eraticus/Squid_old/squid version 14.brd

## EAGLE design squid version 14.brd (2014-09-12)

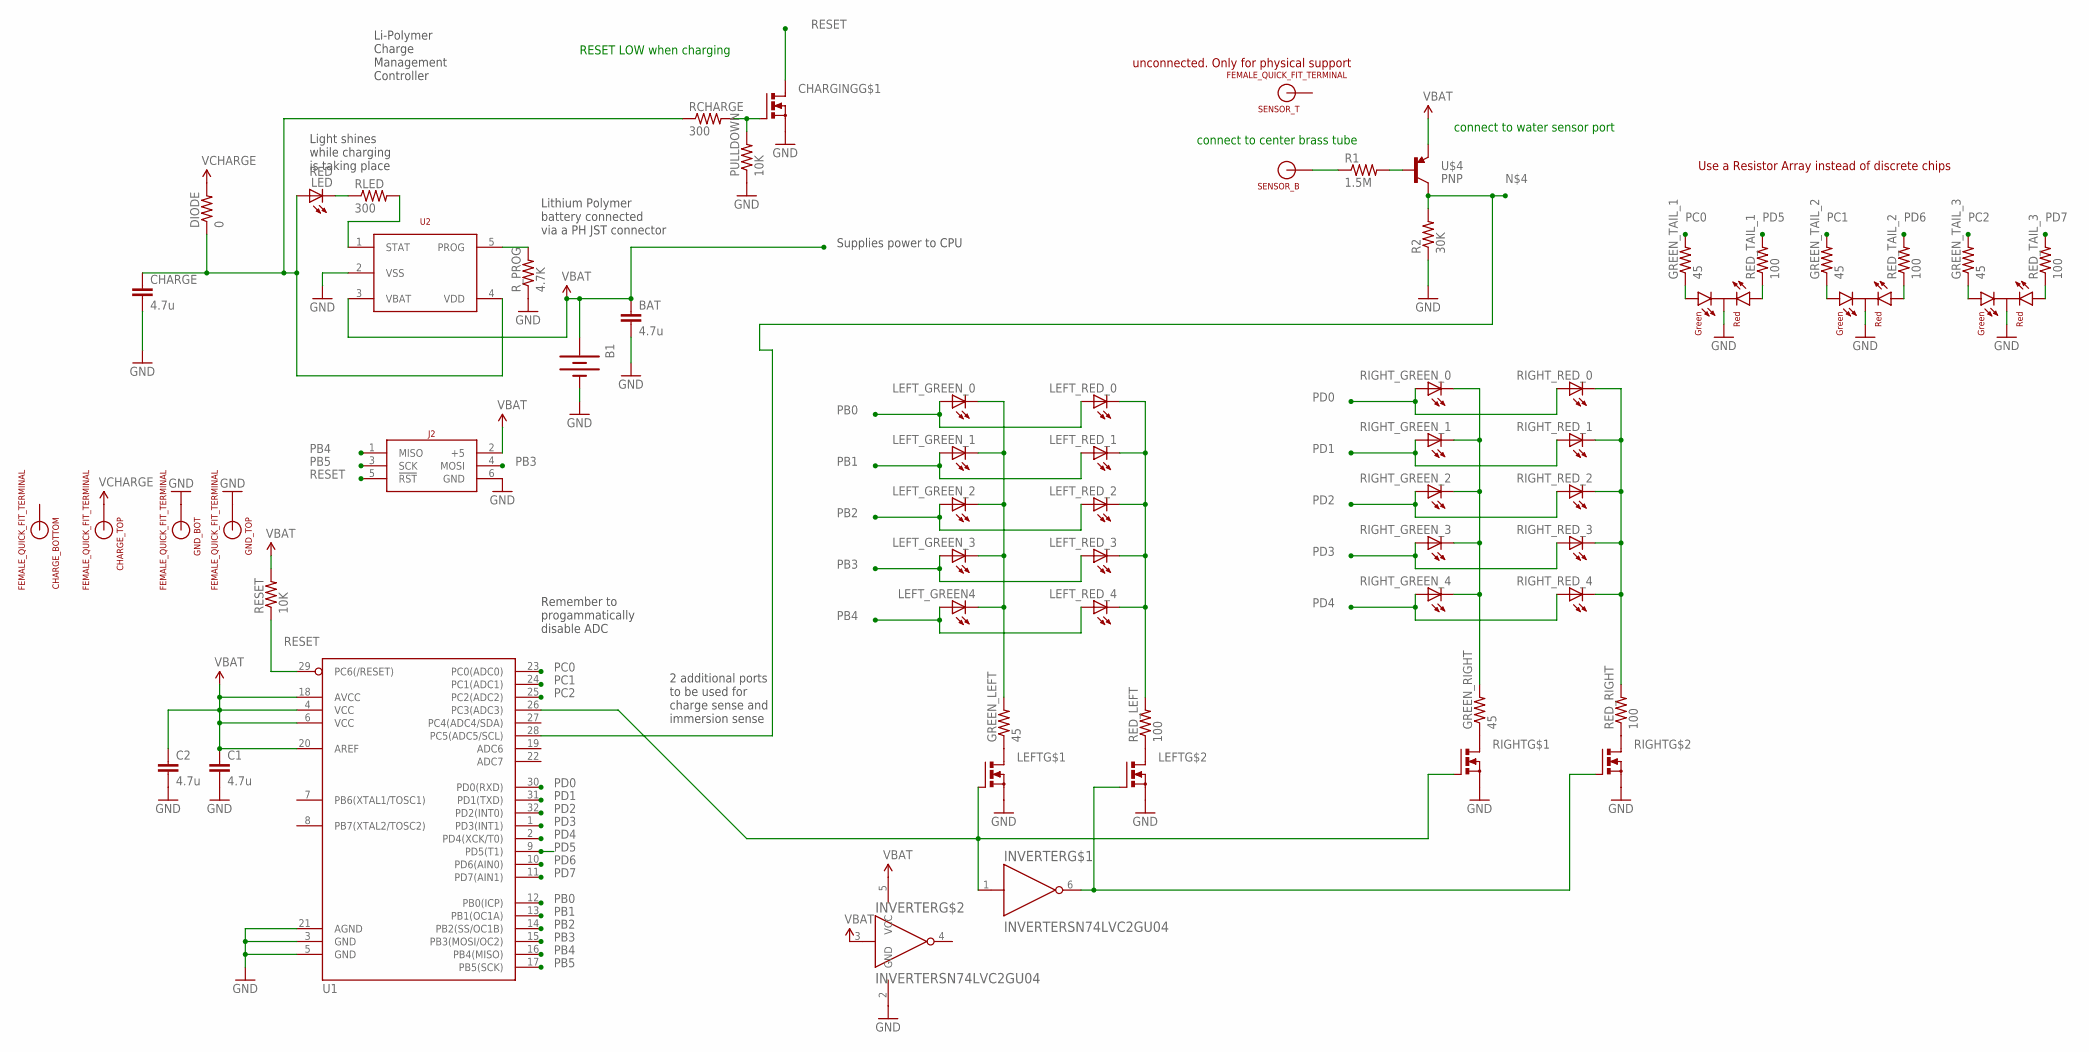
[picture p1: schematic squid version 14.sch]

Parts:
B1: COIN_CELL_BATTERYJST; JST_SM
BAT: 4.7u; 1206
C1, C2: 4.7u; 1206
CENTER: LED_RED_GREEN_CC; LED_KINGBRIGHT_BICOLOR_INDICATOR_LAMP
CHARGE: 4.7u; 1206
CHARGE_BOTTOM: FEMALE_QUICK_FIT_TERMINAL; HORIZONTAL_QUICK_CONNECT_3547
CHARGE_TOP: FEMALE_QUICK_FIT_TERMINAL; HORIZONTAL_QUICK_CONNECT_3547
CHARGING: MOSFET_N_DUAL; SOT-23-6
DIODE: 0; 0805
GND_BOT: FEMALE_QUICK_FIT_TERMINAL; HORIZONTAL_QUICK_CONNECT_3547
GND_TOP: FEMALE_QUICK_FIT_TERMINAL; HORIZONTAL_QUICK_CONNECT_3547
GREEN_LEFT: 45; 0805
GREEN_RIGHT: 45; 0805
GREEN_TAIL_1, GREEN_TAIL_2, GREEN_TAIL_3: 45; 0805
INVERTER: INVERTERSN74LVC2GU04; SOT-23-6
J2: ATMEL_PROGRAMMER_HEADERNL; TC2030-INC-NL
LED: RED; CHIP-LED0805
LEFT: MOSFET_N_DUAL; SOT-23-6
LEFT_GREEN4: LEDPLCC2; BIVAR_2-PLCC
LEFT_GREEN_0, LEFT_GREEN_1, LEFT_GREEN_2, LEFT_GREEN_3: LEDPLCC2; BIVAR_2-PLCC
LEFT_RED_0, LEFT_RED_1, LEFT_RED_2, LEFT_RED_3, LEFT_RED_4: LEDPLCC2; BIVAR_2-PLCC
PULLDOWN: 10K; 0805
R1: 1.5M; 0805
R2: 30K; 0805
RCHARGE: 300; 0805
RED_LEFT: 100; 0805
RED_RIGHT: 100; 0805
RED_TAIL_1, RED_TAIL_2, RED_TAIL_3: 100; 0805
RESET: 10K; 0805
RIGHT: MOSFET_N_DUAL; SOT-23-6
RIGHT_GREEN_0, RIGHT_GREEN_1, RIGHT_GREEN_2, RIGHT_GREEN_3, RIGHT_GREEN_4: LEDPLCC2; BIVAR_2-PLCC
RIGHT_RED_0, RIGHT_RED_1, RIGHT_RED_2, RIGHT_RED_3, RIGHT_RED_4: LEDPLCC2; BIVAR_2-PLCC
RLED: 300; 0805
R_PROG: 4.7K; 0805
SENSOR_B: FEMALE_QUICK_FIT_TERMINAL; HORIZONTAL_QUICK_CONNECT_3547
SENSOR_T: FEMALE_QUICK_FIT_TERMINAL; HORIZONTAL_QUICK_CONNECT_3547
U1: ATMEGA328_SMT; TQFP32-08
U2: MCP73832; SOT-23(OT)5_LEAD
U$4: PNP; SOT-23
U$7, U$13: LED_RED_GREEN_CC; LED_KINGBRIGHT_BICOLOR_INDICATOR_LAMP

Connections:
GND: B1.GND (-), BAT.2, C1.2, C2.2, CENTER.2 (C), CHARGE.2, CHARGING.4 (S), GND_BOT.1, GND_TOP.1, INVERTER.2 (GND), J2.6 (GND), LEFT.1 (S), LEFT.4 (S), PULLDOWN.1, R2.1, RIGHT.1 (S), RIGHT.4 (S), R_PROG.1, U1.3 (GND), U1.5 (GND), U1.21 (AGND), U2.2 (VSS), U$7.2 (C), U$13.2 (C)
GREEN_LEFT_CATHODE: GREEN_LEFT.2, LEFT_GREEN4.C, LEFT_GREEN_0.C, LEFT_GREEN_1.C, LEFT_GREEN_2.C, LEFT_GREEN_3.C
unnamed: R1.2, U$4.1 (B)
unnamed: INVERTER.6 (Y), LEFT.2 (G), RIGHT.2 (G)
unnamed: CHARGING.5 (G), PULLDOWN.2, RCHARGE.2
unnamed: R2.2, U1.28 (PC5(ADC5/SCL)), U$4.3 (C)
unnamed: GREEN_LEFT.1, LEFT.3 (D)
unnamed: LEFT.6 (D), RED_LEFT.1
unnamed: INVERTER.1 (A), LEFT.5 (G), RIGHT.5 (G), U1.26 (PC3(ADC3))
unnamed: GREEN_RIGHT.1, RIGHT.3 (D)
unnamed: R1.1, SENSOR_B.1
unnamed: RED_RIGHT.1, RIGHT.6 (D)
unnamed: GREEN_RIGHT.2, RIGHT_GREEN_0.C, RIGHT_GREEN_1.C, RIGHT_GREEN_2.C, RIGHT_GREEN_3.C, RIGHT_GREEN_4.C
unnamed: RED_RIGHT.2, RIGHT_RED_0.C, RIGHT_RED_1.C, RIGHT_RED_2.C, RIGHT_RED_3.C, RIGHT_RED_4.C
unnamed: LED.C, RLED.1
unnamed: R_PROG.2, U2.5 (PROG)
unnamed: GREEN_TAIL_1.1, U$7.3 (GREEN)
unnamed: CENTER.3 (GREEN), GREEN_TAIL_2.1
unnamed: CHARGE.1, DIODE.1, LED.A, RCHARGE.1, U2.4 (VDD)
unnamed: GREEN_TAIL_3.1, U$13.3 (GREEN)
unnamed: RED_TAIL_1.1, U$7.1 (RED)
unnamed: CENTER.1 (RED), RED_TAIL_2.1
unnamed: RED_TAIL_3.1, U$13.1 (RED)
PB0: LEFT_GREEN_0.A, LEFT_RED_0.A, U1.12 (PB0(ICP))
PB1: LEFT_GREEN_1.A, LEFT_RED_1.A, U1.13 (PB1(OC1A))
PB2: LEFT_GREEN_2.A, LEFT_RED_2.A, U1.14 (PB2(SS/OC1B))
PB3: J2.4 (MOSI), LEFT_GREEN_3.A, LEFT_RED_3.A, U1.15 (PB3(MOSI/OC2))
PB4: J2.1 (MISO), LEFT_GREEN4.A, LEFT_RED_4.A, U1.16 (PB4(MISO))
PB5: J2.3 (SCK), U1.17 (PB5(SCK))
PC0: GREEN_TAIL_1.2, U1.23 (PC0(ADC0))
PC1: GREEN_TAIL_2.2, U1.24 (PC1(ADC1))
PC2: GREEN_TAIL_3.2, U1.25 (PC2(ADC2))
PD0: RIGHT_GREEN_0.A, RIGHT_RED_0.A, U1.30 (PD0(RXD))
PD1: RIGHT_GREEN_1.A, RIGHT_RED_1.A, U1.31 (PD1(TXD))
PD2: RIGHT_GREEN_2.A, RIGHT_RED_2.A, U1.32 (PD2(INT0))
PD3: RIGHT_GREEN_3.A, RIGHT_RED_3.A, U1.1 (PD3(INT1))
PD4: RIGHT_GREEN_4.A, RIGHT_RED_4.A, U1.2 (PD4(XCK/T0))
PD5: RED_TAIL_1.2, U1.9 (PD5(T1))
PD6: RED_TAIL_2.2, U1.10 (PD6(AIN0))
PD7: RED_TAIL_3.2, U1.11 (PD7(AIN1))
RED_LEFT_CATHODE: LEFT_RED_0.C, LEFT_RED_1.C, LEFT_RED_2.C, LEFT_RED_3.C, LEFT_RED_4.C, RED_LEFT.2
RESET: CHARGING.3 (D), J2.5 (!RST!), RESET.1, U1.29 (PC6(/RESET))
STAT: RLED.2, U2.1 (STAT)
VBAT: B1.VCC (+), BAT.1, C1.1, C2.1, INVERTER.3 (A), INVERTER.5 (VCC), J2.2 (+5), RESET.2, U1.4 (VCC), U1.6 (VCC), U1.18 (AVCC), U1.20 (AREF), U2.3 (VBAT), U$4.2 (E)
VCHARGE: CHARGE_TOP.1, DIODE.2

Notes on the sheet:
2 additional ports to be used for charge sense and immersion sense
Lithium Polymer battery connected via a PH JST connector
Light shines while charging is taking place
Supplies power to CPU
Li-Polymer Charge Management Controller
Remember to progammatically disable ADC
connect to center brass tube
connect to water sensor port
RESET LOW when charging
Use a Resistor Array instead of discrete chips
unconnected. Only for physical support

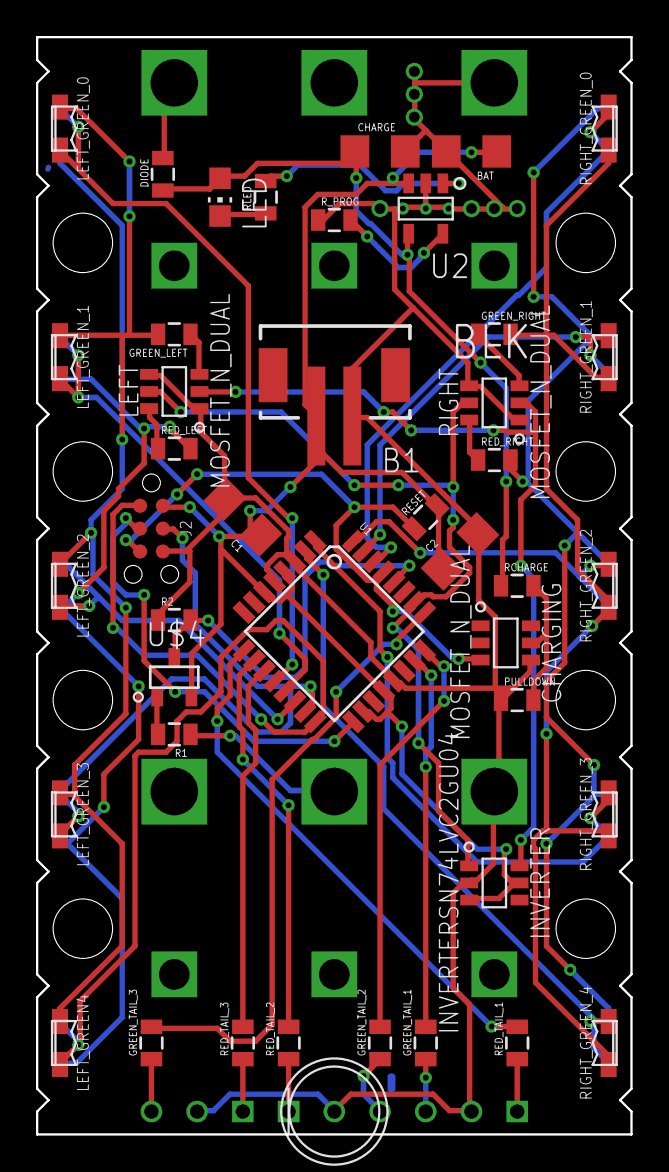
[picture p2: board squid version 14.brd from above]

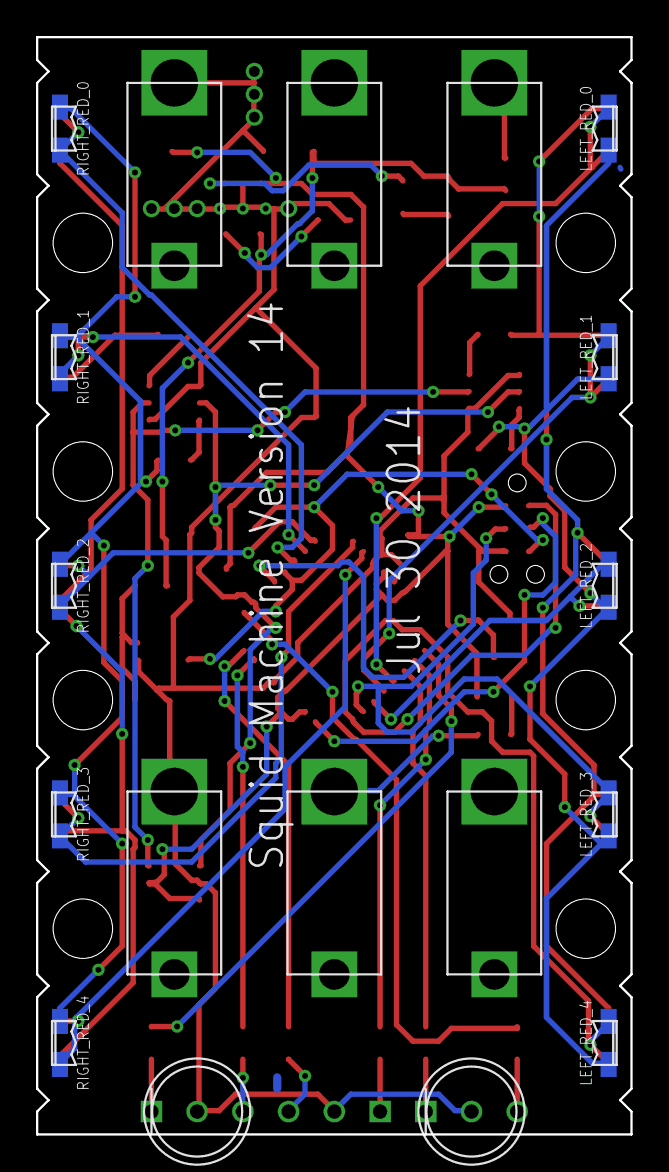
[picture p3: board squid version 14.brd from below]

Board: 2 copper layers, 33.0 x 61.0 mm, 62 parts (18 on the bottom side), 45 nets.

Other parts of the board:
U$12: SQUID_14
