eraticus/Squid_old/(commit log)

2014-07-30 Initial commit of Squid project
    Includes schematic, board, and program
    [squid version 13.brd, squid version 13.sch, squid version 14.brd, squid version 14.sch]
2014-07-31 small test change
    [squid version 14.brd]
2014-07-31 put RG TH lights in rear
    Rearranged board to hold TH parts in rear.
    [squid version 14.sch]
2014-07-31 add label
    minor change
    [squid version 14.brd, squid version 14.sch]
2014-07-31 added some comments
    [squid version 14.brd, squid version 14.sch]
2014-08-01 disconnect top center tube holder
    Does not need an electrical connection
    [squid version 14.brd, squid version 14.sch]
2014-09-05 assign values of ballast resistors
    Put proper values of ballast resistors into schematic
    [squid version 14.brd, squid version 14.sch]
2014-09-05 reverse lateral light display
    change direction of lateral light display from head to tail, to tail to
    head
    [squid_version_13.ino]
2014-09-09 change speed and direction of lights
    Lights sped up, and reversed. Tail lights make clockwise pattern
    instead of back and forth
    [squid_version_13.ino]
2014-09-12 correct current programming resistor value
    Major mistake in current programming resistor!! Changed from 24 to
    4.7K!!!
    [squid version 14.brd, squid version 14.sch]
